LeoMos10/Devboard/BOM.csv

References | Qty per board | Value | MFR Part # | Footprint (schematic) | JLCPCB Part # | Cart Qty | JLCPCB Link | Cart check | Assembly
U1 | 1 | RP2354B | RP2354B | Package_DFN_QFN:QFN-80-1EP_10x10mm_P0.4mm_EP3.4x3.4mm | C39843328 | 2 | https://jlcpcb.com/partdetail/C39843328 | One spare in cart | PCBA
U3 | 1 | 3.3V LDO | MCP1700T-3302E/TT | Package_TO_SOT_SMD:SOT-23 | C39051 | 1 | https://jlcpcb.com/partdetail/C39051 | Matched | PCBA
J1 | 1 | USB-C | TYPE-C-31-M-12 | Connector_USB:USB_C_Receptacle_HRO_TYPE-C-31-M-12 | C165948 | 1 | https://jlcpcb.com/partdetail/C165948 | Matched | PCBA
L1 | 1 | 3.3uH | AOTA-B201610S3R3-101-T | EasyEDA_Imported:IND-SMD_L2.0-W1.6_AOTA-B201610S3R3-101-T | C42411119 | 1 | https://jlcpcb.com/partdetail/AbraconLLC-AOTA_B201610S3R3_101T/C42411119 | Quantity matched; availability reported unavailable | PCBA
D1 | 1 | Schottky diode | B5819W SL | Diode_SMD:D_SOD-123 | C8598 | 1 | https://jlcpcb.com/partdetail/C8598 | Matched | PCBA
D2 | 1 | RGB LED common anode | TJ-S3528UG2W9TLCCYRGB-A5 | EasyEDA_Imported:LED-ARRAY-SMD_4P-L3.2-W2.7-TL-RD_TJ-S3528 | C601699 | 1 | https://jlcpcb.com/partdetail/C601699 | Matched | PCBA
D3 | 1 | Yellow LED | KT-0805Y | LED_SMD:LED_0805_2012Metric | C2296 | 1 | https://jlcpcb.com/partdetail/C2296 | Matched | PCBA
Y1 | 1 | 12MHz crystal | ABM8-272-T3 | Crystal:Crystal_SMD_3225-4Pin_3.2x2.5mm | C20625731 | 1 | https://jlcpcb.com/partdetail/C20625731 | Matched | PCBA
SW1,SW2,SW3,SW4 | 4 | Push button | TS-1088-AR02016 | Button_Switch_SMD:SW_SPST_TS-1088-xR020 | C720477 | 4 | https://jlcpcb.com/partdetail/C720477 | Matched | PCBA
C1,C2,C3 | 3 | 10uF | CL10A106KP8NNNC | Capacitor_SMD:C_0603_1608Metric | C19702 | 3 | https://jlcpcb.com/partdetail/C19702 | Matched | PCBA
C7,C8 | 2 | 15pF | 0402CG150J500NT | Capacitor_SMD:C_0402_1005Metric | C1548 | 2 | https://jlcpcb.com/partdetail/C1548 | Matched | PCBA
C4,C5,C10,C11,C12,C13,C14,C15,C16 | 9 | 100nF | CL05B104KO5NNNC | Capacitor_SMD:C_0402_1005Metric | C1525 | 9 | https://jlcpcb.com/partdetail/C1525 | Matched | PCBA
C6,C17 | 2 | 4.7uF | CL10A475KO8NNNC | Capacitor_SMD:C_0603_1608Metric | C19666 | 2 | https://jlcpcb.com/partdetail/C19666 | Matched | PCBA
C9 | 1 | 1uF | CL05A105KA5NQNC | Capacitor_SMD:C_0402_1005Metric | C52923 | 1 | https://jlcpcb.com/partdetail/C52923 | Matched | PCBA
R1,R2 | 2 | 5.1k | 0402WGF5101TCE | Resistor_SMD:R_0402_1005Metric | C25905 | 2 | https://jlcpcb.com/partdetail/C25905 | Matched | PCBA
R3,R4 | 2 | 27R | 0402WGF270JTCE | Resistor_SMD:R_0402_1005Metric | C25100 | 2 | https://jlcpcb.com/partdetail/25843-0402WGF270JTCE/C25100 | Quantity matched; availability reported unavailable | PCBA
R5,R10 | 2 | 1k | 0402WGF1001TCE | Resistor_SMD:R_0402_1005Metric | C11702 | 2 | https://jlcpcb.com/partdetail/C11702 | Matched | PCBA
R6,R7,R8,R9 | 4 | 330R | 0402WGF3300TCE | Resistor_SMD:R_0402_1005Metric | C25104 | 4 | https://jlcpcb.com/partdetail/C25104 | Matched | PCBA
R11 | 1 | 33R | 0402WGF330JTCE | Resistor_SMD:R_0402_1005Metric | C25105 | 1 | https://jlcpcb.com/partdetail/C25105 | Matched | PCBA
J2 | 1 | 1x20 pin header 2.54mm |  | leo/kicad_vari:goood_PinHeader_1x20_P2.54mm_Vertical_left_cutom_pad |  | 0 |  | Not in cart | Hand solder
J6 | 1 | 1x20 pin header 2.54mm |  | leo/kicad_vari:goood_PinHeader_1x20_P2.54mm_Vertical_right_cutom_pad |  | 0 |  | Not in cart | Hand solder
J3,J5 | 2 | 1x04 pin header 2.54mm |  | Connector_PinHeader_2.54mm:PinHeader_1x04_P2.54mm_Vertical |  | 0 |  | Not in cart | Hand solder
J4 | 1 | 1x03 pin header 2.54mm |  | Connector_PinHeader_2.54mm:PinHeader_1x03_P2.54mm_Vertical |  | 0 |  | Not in cart | Hand solder
