LeoMos10/Devboard/PCB/devboard.kicad_pcb

## KiCad design PCB/devboard.kicad_pcb (2026-10-11)

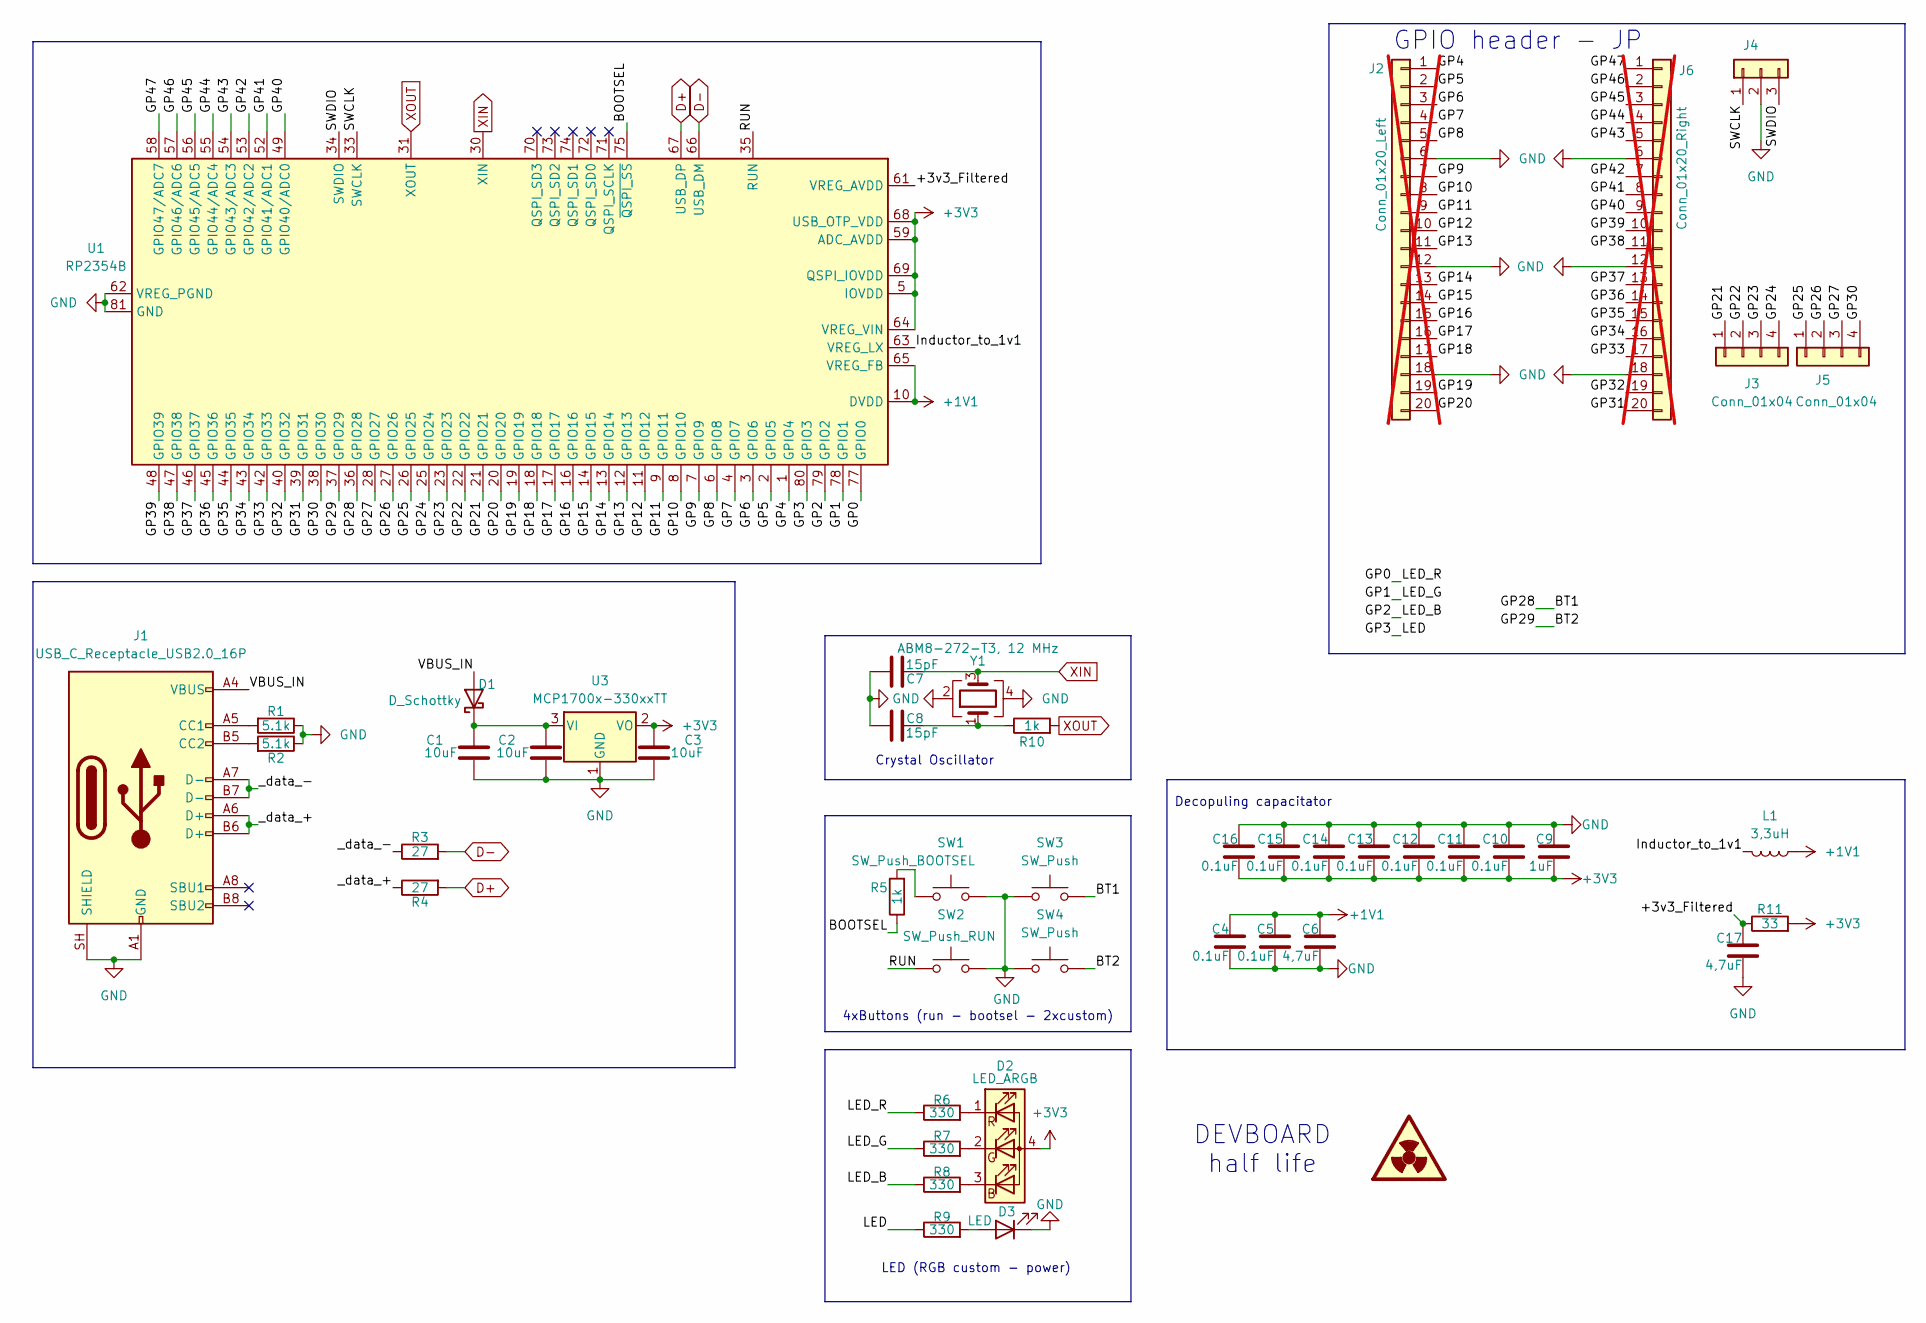
[picture p9: schematic devboard.kicad_sch]

Parts:
C1, C2, C3: 10uF; C_0603_1608Metric
C4, C5, C10, C11, C12, C13, C14, C15, C16: 0.1uF; C_0402_1005Metric
C6, C17: 4,7uF; C_0603_1608Metric
C7, C8: 15pF; C_0402_1005Metric
C9: 1uF; C_0402_1005Metric
D1: D_Schottky; D_SOD-123
D2: LED_ARGB; LED-ARRAY-SMD_4P-L3.2-W2.7-TL-RD_TJ-S3528
D3: LED; LED_0805_2012Metric
J1: USB_C_Receptacle_USB2.0_16P; USB_C_Receptacle_HRO_TYPE-C-31-M-12
J2: Conn_01x20_Left; goood_PinHeader_1x20_P2.54mm_Vertical_left_cutom_pad; not fitted
J3, J5: Conn_01x04; PinHeader_1x04_P2.54mm_Vertical
J4: Conn_01x03; PinHeader_1x03_P2.54mm_Vertical
J6: Conn_01x20_Right; goood_PinHeader_1x20_P2.54mm_Vertical_right_cutom_pad; not fitted
L1: 3,3uH; IND-SMD_L2.0-W1.6_AOTA-B201610S3R3-101-T
R1, R2: 5.1k; R_0402_1005Metric
R3, R4: 27; R_0402_1005Metric
R5, R10: 1k; R_0402_1005Metric
R6, R7, R8, R9: 330; R_0402_1005Metric
R11: 33; R_0402_1005Metric
SW1: SW_Push_BOOTSEL; SW_SPST_TS-1088-xR020
SW2: SW_Push_RUN; SW_SPST_TS-1088-xR020
SW3, SW4: SW_Push; SW_SPST_TS-1088-xR020
U1: RP2354B; QFN-80-1EP_10x10mm_P0.4mm_EP3.4x3.4mm
U3: MCP1700x-330xxTT; SOT-23
Y1: ABM8-272-T3, 12 MHz; Crystal_SMD_3225-4Pin_3.2x2.5mm

Connections:
+1V1: C4.1, C5.1, C6.1, L1.1, U1.10 (DVDD), U1.32 (DVDD), U1.51 (DVDD), U1.65 (VREG_FB)
+3V3: C3.1, C9.2, C10.2, C11.2, C12.2, C13.2, C14.2, C15.2, C16.2, D2.4 (A), R11.2, U1.5 (IOVDD), U1.15 (IOVDD), U1.24 (IOVDD), U1.29 (IOVDD), U1.41 (IOVDD), U1.50 (IOVDD), U1.59 (ADC_AVDD), U1.60 (IOVDD), U1.64 (VREG_VIN), U1.68 (USB_OTP_VDD), U1.69 (QSPI_IOVDD), U1.76 (IOVDD), U3.2 (VO)
/+3v3_Filtered: C17.1, R11.1, U1.61 (VREG_AVDD)
/BOOTSEL: R5.1, U1.75 (~QSPI_SS)
/BT1: SW3.2, U1.36 (GPIO28)
/BT2: SW4.2, U1.37 (GPIO29)
/GP0: R6.1, U1.77 (GPIO0)
/GP1: R7.1, U1.78 (GPIO1)
/GP2: R8.1, U1.79 (GPIO2)
/GP3: R9.1, U1.80 (GPIO3)
/GP4: J2.1, U1.1 (GPIO4)
/GP5: J2.2, U1.2 (GPIO5)
/GP6: J2.3, U1.3 (GPIO6)
/GP7: J2.4, U1.4 (GPIO7)
/GP8: J2.5, U1.6 (GPIO8)
/GP9: J2.7, U1.7 (GPIO9)
/GP10: J2.8, U1.8 (GPIO10)
/GP11: J2.9, U1.9 (GPIO11)
/GP12: J2.10, U1.11 (GPIO12)
/GP13: J2.11, U1.12 (GPIO13)
/GP14: J2.13, U1.13 (GPIO14)
/GP15: J2.14, U1.14 (GPIO15)
/GP16: J2.15, U1.16 (GPIO16)
/GP17: J2.16, U1.17 (GPIO17)
/GP18: J2.17, U1.18 (GPIO18)
/GP19: J2.19, U1.19 (GPIO19)
/GP20: J2.20, U1.20 (GPIO20)
/GP21: J3.1, U1.21 (GPIO21)
/GP22: J3.2, U1.22 (GPIO22)
/GP23: J3.3, U1.23 (GPIO23)
/GP24: J3.4, U1.25 (GPIO24)
/GP25: J5.1, U1.26 (GPIO25)
/GP26: J5.2, U1.27 (GPIO26)
/GP27: J5.3, U1.28 (GPIO27)
/GP30: J5.4, U1.38 (GPIO30)
/GP31: J6.20, U1.39 (GPIO31)
/GP32: J6.19, U1.40 (GPIO32)
/GP33: J6.17, U1.42 (GPIO33)
/GP34: J6.16, U1.43 (GPIO34)
/GP35: J6.15, U1.44 (GPIO35)
/GP36: J6.14, U1.45 (GPIO36)
/GP37: J6.13, U1.46 (GPIO37)
/GP38: J6.11, U1.47 (GPIO38)
/GP39: J6.10, U1.48 (GPIO39)
/GP40: J6.9, U1.49 (GPIO40/ADC0)
/GP41: J6.8, U1.52 (GPIO41/ADC1)
/GP42: J6.7, U1.53 (GPIO42/ADC2)
/GP43: J6.5, U1.54 (GPIO43/ADC3)
/GP44: J6.4, U1.55 (GPIO44/ADC4)
/GP45: J6.3, U1.56 (GPIO45/ADC5)
/GP46: J6.2, U1.57 (GPIO46/ADC6)
/GP47: J6.1, U1.58 (GPIO47/ADC7)
/Inductor_to_1v1: L1.2, U1.63 (VREG_LX)
/RUN: SW2.1, U1.35 (RUN)
/SWCLK: J4.1, U1.33 (SWCLK)
/SWDIO: J4.3, U1.34 (SWDIO)
/VBUS_IN: D1.2 (A), J1.A4 (VBUS), J1.A9 (VBUS), J1.B4 (VBUS), J1.B9 (VBUS)
/_data_+: J1.A6 (D+), J1.B6 (D+), R4.1
/_data_-: J1.A7 (D-), J1.B7 (D-), R3.1
D+: R4.2, U1.67 (USB_DP)
D-: R3.2, U1.66 (USB_DM)
GND: C1.2, C2.2, C3.2, C4.2, C5.2, C6.2, C7.1, C8.1, C9.1, C10.1, C11.1, C12.1, C13.1, C14.1, C15.1, C16.1, C17.2, D3.1 (K), J1.A1 (GND), J1.A12 (GND), J1.B1 (GND), J1.B12 (GND), J1.SH (SHIELD), J2.6, J2.12, J2.18, J4.2, J6.6, J6.12, J6.18, R1.1, R2.1, SW1.2, SW2.2, SW3.1, SW4.1, U1.62 (VREG_PGND), U1.81 (GND), U3.1 (GND), Y1.2, Y1.4
unnamed: C8.2, R10.1, Y1.1
unnamed: C1.1, C2.1, D1.1 (K), U3.3 (VI)
unnamed: D2.3 (BK), R8.2
unnamed: D2.1 (GK), R6.2
unnamed: D2.2 (RK), R7.2
unnamed: D3.2 (A), R9.2
unnamed: J1.A5 (CC1), R1.2
unnamed: J1.B5 (CC2), R2.2
unnamed: R5.2, SW1.1
XIN: C7.2, U1.30 (XIN), Y1.3
XOUT: R10.2, U1.31 (XOUT)

Notes on the sheet:
4xButtons (run - bootsel - 2xcustom)
DEVBOARD half life
GPIO header - JP
Decopuling capacitator
Crystal Oscillator
LED (RGB custom - power)

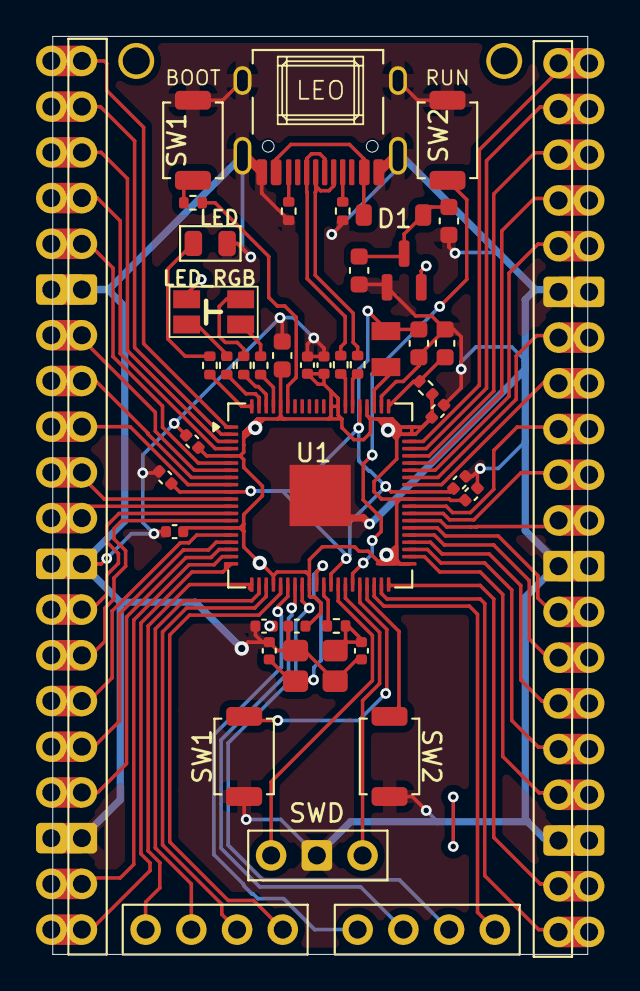
[picture p10: board devboard.kicad_pcb from above]

Board: 2 copper layers, 29.7 x 51.0 mm, 45 parts (0 on the bottom side), 73 nets.
